SaraEye/SaraKIT-Schematic-and-BOM/SaraKit_MainBoard/support/RPI_CM4_Pinout.JPG

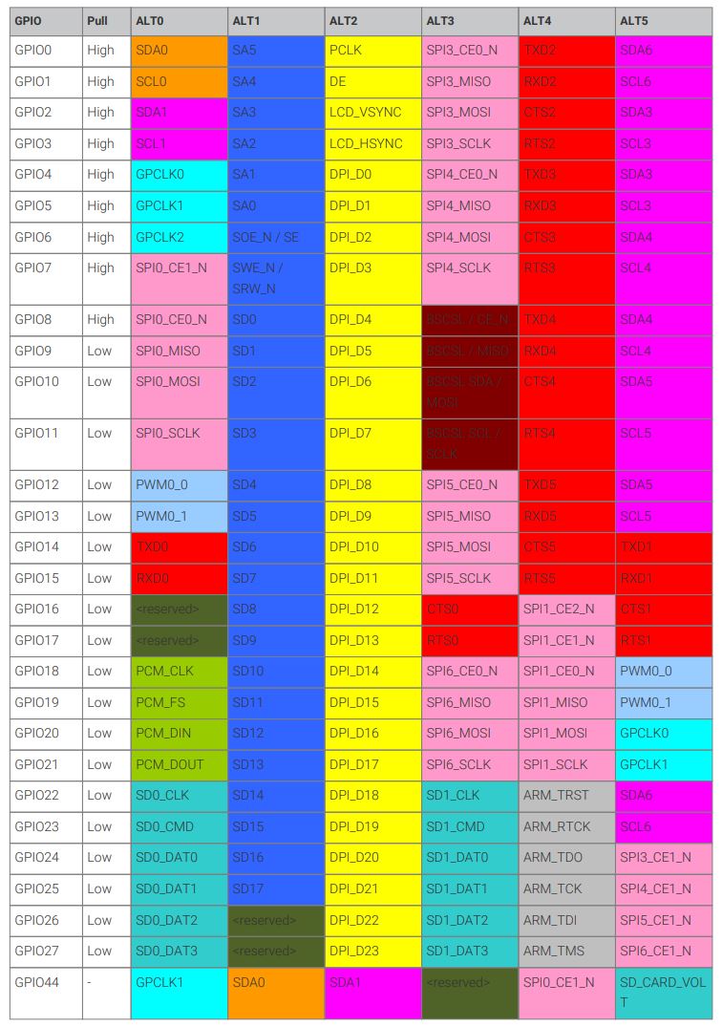
SaraKit_MainBoard/support/RPI_CM4_Pinout.JPG
