SaraEye/SaraKIT-Schematic-and-BOM/README.md

## SaraKIT Schematic and BOM

---

## SaraAI LLC

Website: [https://SaraAI.com](https://SaraAI.com)<br>
Project Page: [https://SaraKIT.SaraAI.com](https://SaraKIT.SaraAI.com)
