SaraEye/SaraKIT-Schematic-and-BOM/SaraKit_CameraHub_v11/out/[ASSEMBLY] SaraKit_CameraHub-v1.1 (2023-07-04)/BOM/[eBOM] SaraKit_CameraHub [Standard] [v1.1] (2023-07-04 18-40).xlsx

eBOM | SaraKit Camera Hub
Project: | SaraKit_CameraHub.PrjPcb |  |  |  |  |  |  | Quantity of devices: | 1
Variant: | Standard |  |  |  |  |  |  | Total price: | 0.00 USD
Version | v1.1 |  |  |  |  |  |  | One device price | 0.00 USD
Report Date: | 04.07.2023 | 18:40
Print Date: | 2023-07-04 | 18:41:01
Designator | Quantity | 02 MPN | 03 Manufacturer | 04 Main Group | 05 Sub Group | 06 Assembly | 16 Replacements | 19 Supplier | 21 Price 1 USD | 22 Price 10 USD | 23 Price 100 USD | 24 Price 1000 USD | Total Quantity of Elements | Total Price of Elements | Percent of device price
C1 | 1 | CL21A226MOQNNNE | Samsung | CAPACITOR | CERAMIC | SMT |  |  |  |  |  |  | 1 | 0.00 USD | #DIV/0!
C2, C3 | 2 | CL05A105KO5NNNC | Samsung | CAPACITOR | THICK FILM | SMT |  |  |  |  |  |  | 2 | 0.00 USD | #DIV/0!
J1 | 1 | 5046184012 | Molex | CONNECTOR | PCB | SMT |  |  |  |  |  |  | 1 | 0.00 USD | #DIV/0!
J2, J3 | 2 | 1-84952-5 | TE Connectivity | CONNECTOR | PCB | SMT |  |  |  |  |  |  | 2 | 0.00 USD | #DIV/0!
R1, R2, R3, R4 | 4 | RC0402JR-070RL | Yageo | RESISTOR | THICK FILM | SMT |  |  |  |  |  |  | 4 | 0.00 USD | #DIV/0!
R5, R6 | 2 | RC0402FR-0710KL | Yageo | RESISTOR | THICK FILM | SMT |  |  |  |  |  |  | 2 | 0.00 USD | #DIV/0!
U1 | 1 | LIS3DH | STMicroelectronics | IC | SENSOR | SMT |  |  |  |  |  |  | 1 | 0.00 USD | #DIV/0!
