SaraEye/SaraKIT-Schematic-and-BOM/SaraKit_FlexHubConnector/out/[ASSEMBLY] SaraKit_FlexHubConnector-v1.0 (2023-07-04)/BOM/[eBOM] SaraKit_FlexHubConnector [[No Variations]] [v1.0] (2023-07-04 18-42).xlsx

eBOM | SaraKit FlexHubConnector
Project: | SaraKit_FlexHubConnector.PrjPcb |  |  |  |  |  |  | Quantity of devices: | 1
Variant: | None |  |  |  |  |  |  | Total price: | 0.00 USD
Version | v1.0 |  |  |  |  |  |  | One device price | 0.00 USD
Report Date: | 04.07.2023 | 18:42
Print Date: | 2023-07-04 | 18:42:34
Designator | Quantity | 02 MPN | 03 Manufacturer | 04 Main Group | 05 Sub Group | 06 Assembly | #Column Name Error:' 16 Replacements | #Column Name Error:' 19 Supplier | #Column Name Error:' 21 Price 1 USD | #Column Name Error:' 22 Price 10 USD | #Column Name Error:' 23 Price 100 USD | #Column Name Error:' 24 Price 1000 USD | Total Quantity of Elements | Total Price of Elements | Percent of device price
J1, J2 | 2 | 5046224012 | Molex | CONNECTOR | PCB | SMT |  |  |  |  |  |  | 2 | 0.00 USD | #DIV/0!
 |  |  |  |  |  |  |  |  |  |  |  |  | 0 | 0.00 USD | #DIV/0!
 |  |  |  |  |  |  |  |  |  |  |  |  | 0 | 0.00 USD | #DIV/0!
