SaraEye/SaraKIT-Schematic-and-BOM/SaraKit_MainBoard/out/[ASSEMBLY] SaraKit_MainBoard-v1.1 (2023-07-04)/BOM/[eBOM] SaraKit_MainBoard [Standard] [v1.1] (2023-07-04 18-44).xlsx

eBOM | SaraKit Main Board
Project: | SaraKit_MainBoard.PrjPcb |  |  |  |  |  |  | Quantity of devices: | 1
Variant: | Standard |  |  |  |  |  |  | Total price: | 0.00 USD
Version | v1.1 |  |  |  |  |  |  | One device price | 0.00 USD
Report Date: | 04.07.2023 | 18:44
Print Date: | 2023-07-04 | 18:45:00
Designator | Quantity | 02 MPN | 03 Manufacturer | 04 Main Group | 05 Sub Group | 06 Assembly | 16 Replacements | 19 Supplier | 21 Price 1 USD | 22 Price 10 USD | 23 Price 100 USD | 24 Price 1000 USD | Total Quantity of Elements | Total Price of Elements | Percent of device price
ASM100 | 1 | CM4101008 | Raspberry Pi | IC | PROCESSOR | FAS |  |  |  |  |  |  | 1 | 0.00 USD | #DIV/0!
C100, C101, C106, C107, C216, C220, C221, C223, C225, C226, C228, C229, C230, C306, C308, C313, C315, C411, C412, C413, C422 | 21 | CL05A105KP5NNNC | Samsung | CAPACITOR | THICK FILM | SMT |  |  |  |  |  |  | 21 | 0.00 USD | #DIV/0!
C102, C103, C424, C509, C511, C512 | 6 | CL21A226MOQNNNE | Samsung | CAPACITOR | CERAMIC | SMT |  |  |  |  |  |  | 6 | 0.00 USD | #DIV/0!
C200, C203, C204, C205 | 4 | CL10A105KO8NNNC | Samsung | CAPACITOR | CERAMIC | SMT |  |  |  |  |  |  | 4 | 0.00 USD | #DIV/0!
C208, C209, C210, C211, C212, C213, C214, C215, C217, C218, C219, C222, C224, C400, C410, C423, C500 | 17 | CL05B104KO5NNNC | Samsung | CAPACITOR | CERAMIC | SMT |  |  |  |  |  |  | 17 | 0.00 USD | #DIV/0!
C300, C301, C401 | 3 | A768EB826M1ELAE036 | Kemet | CAPACITOR | POLYMER | SMT | 25SVPK82M |  |  |  |  |  | 3 | 0.00 USD | #DIV/0!
C302, C303, C304, C305, C307, C309 | 6 | CL21B105KBFNNNG | Samsung | CAPACITOR | CERAMIC | SMT |  |  |  |  |  |  | 6 | 0.00 USD | #DIV/0!
C310, C311, C316, C317 | 4 | CL10B474KA8NNNC | Samsung | CAPACITOR | CERAMIC | SMT |  |  |  |  |  |  | 4 | 0.00 USD | #DIV/0!
C312, C314, C318, C319 | 4 | CL10B102KB8NNNC | Samsung | CAPACITOR | CERAMIC | SMT |  |  |  |  |  |  | 4 | 0.00 USD | #DIV/0!
C320, C321 | 2 | CL05B103KB5NNN | Samsung | CAPACITOR | CERAMIC | SMT |  |  |  |  |  |  | 2 | 0.00 USD | #DIV/0!
C402, C403, C414, C415, C502, C503 | 6 | CL32B106KBJNNNE | Samsung | CAPACITOR | CERAMIC | SMT |  |  |  |  |  |  | 6 | 0.00 USD | #DIV/0!
C404, C416, C505 | 3 | CL10B104KB8NNNC | Samsung | CAPACITOR | CERAMIC | SMT |  |  |  |  |  |  | 3 | 0.00 USD | #DIV/0!
C405, C417 | 2 | CL10B103KB8NNNC | Samsung | CAPACITOR | CERAMIC | SMT |  |  |  |  |  |  | 2 | 0.00 USD | #DIV/0!
C406 | 1 | C0402C681J5GAC | Kemet | CAPACITOR | CERAMIC | SMT |  |  |  |  |  |  | 1 | 0.00 USD | #DIV/0!
C409, C421 | 2 | CL10B105KA8NNNC | Samsung | CAPACITOR | CERAMIC | SMT |  |  |  |  |  |  | 2 | 0.00 USD | #DIV/0!
C504 | 1 | CL10B332KB8NNNC | Samsung | CAPACITOR | CERAMIC | SMT |  |  |  |  |  |  | 1 | 0.00 USD | #DIV/0!
C506, C507 | 2 | ECASD40J476M025K00 | Murata | CAPACITOR | POLYMER | SMT |  |  |  |  |  |  | 2 | 0.00 USD | #DIV/0!
C513 | 1 | GRM1555C1H101JA01D | Murata | CAPACITOR | CERAMIC | SMT |  |  |  |  |  |  | 1 | 0.00 USD | #DIV/0!
C600, C601 | 2 | CL05A105KO5NNNC | Samsung | CAPACITOR | THICK FILM | SMT |  |  |  |  |  |  | 2 | 0.00 USD | #DIV/0!
D100 | 1 | TPD2E2U06DCKR | Texas Instruments | DIODE | TVS/ESD | SMT |  |  |  |  |  |  | 1 | 0.00 USD | #DIV/0!
D504, D505 | 2 | SK34A | Taiwan Semiconductor | DIODE | SCHOTTKY | SMT |  |  |  |  |  |  | 2 | 0.00 USD | #DIV/0!
J100, J101 | 2 | DF40HC(3.0)-100DS-0.4v | Hirose | CONNECTOR | PCB | SMT |  |  |  |  |  |  | 2 | 0.00 USD | #DIV/0!
J102 | 1 | 5046184012 | Molex | CONNECTOR | PCB | SMT |  |  |  |  |  |  | 1 | 0.00 USD | #DIV/0!
J103 | 1 | USB3140-30-0170-0-C | GCT | CONNECTOR | WIRE | SMD/THT |  |  |  |  |  |  | 1 | 0.00 USD | #DIV/0!
J104, J105 | 2 | 10129381-910001BLF | Amphenol | CONNECTOR | WIRE | THT |  |  |  |  |  |  | 2 | 0.00 USD | #DIV/0!
J300, J301 | 2 | 282834-2 | TE Connectivity | CONNECTOR | WIRE | THT |  |  |  |  |  |  | 2 | 0.00 USD | #DIV/0!
J400, J401 | 2 | 282834-3 | TE Connectivity | CONNECTOR | WIRE | THT |  |  |  |  |  |  | 2 | 0.00 USD | #DIV/0!
J402, J404 | 2 | 53047-0310 | Molex | CONNECTOR | WIRE | THT |  |  |  |  |  |  | 2 | 0.00 USD | #DIV/0!
J403 | 1 | G800W303018EU | Amphenol | CONNECTOR | WIRE | THT |  |  |  |  |  |  | 1 | 0.00 USD | #DIV/0!
J500 | 1 | PC-GK2.1 | NINIGI | CONNECTOR | WIRE | THT |  |  |  |  |  |  | 1 | 0.00 USD | #DIV/0!
L300, L301, L302, L303 | 4 | BLM21PG121SN1D | Murata | INDUCTOR | BEAD | SMT |  |  |  |  |  |  | 4 | 0.00 USD | #DIV/0!
L502 | 1 | SRR1050A-8R2Y | Bourns | INDUCTOR | WIREWOUND | SMT |  |  |  |  |  |  | 1 | 0.00 USD | #DIV/0!
L503 | 1 | SRN2510F-2R2M | Bourns | INDUCTOR | WIREWOUND | SMT |  |  |  |  |  |  | 1 | 0.00 USD | #DIV/0!
MIC200, MIC201, MIC202 | 3 | SPH0655LM4H-1 | Knowles | ACOUSTIC | MICROPHONE | SMT |  |  |  |  |  |  | 3 | 0.00 USD | #DIV/0!
Q100, Q300 | 2 | BC817-40W | Nexperia | TRANSISTOR | BIPOLAR | SMT |  |  |  |  |  |  | 2 | 0.00 USD | #DIV/0!
Q200 | 1 | IRLML2246TRPBF | International Rectifier | TRANSISTOR | MOSFET | SMT |  |  |  |  |  |  | 1 | 0.00 USD | #DIV/0!
R101, R102, R103, R104, R105, R106 | 6 | RC0603FR-074K7L | Yageo | RESISTOR | THICK FILM | SMT |  |  |  |  |  |  | 6 | 0.00 USD | #DIV/0!
R108, R200, R201, R203, R204, R207, R210, R212, R213, R501 | 10 | RC0603FR-0722RL | Yageo | RESISTOR | THICK FILM | SMT |  |  |  |  |  |  | 10 | 0.00 USD | #DIV/0!
R109, R202, R205, R206, R216, R218, R219, R220, R222, R300, R401, R405, R406, R410, R411, R412, R413, R505 | 18 | RC0402FR-0710KL | Yageo | RESISTOR | THICK FILM | SMT |  |  |  |  |  |  | 18 | 0.00 USD | #DIV/0!
R208, R301, R306, R307, R509 | 5 | RC0402FR-07100KL | Yageo | RESISTOR | THICK FILM | SMT |  |  |  |  |  |  | 5 | 0.00 USD | #DIV/0!
R211, R402 | 2 | 0402WGJ0101TCE | Royal Ohm | RESISTOR | THICK FILM | SMT |  |  |  |  |  |  | 2 | 0.00 USD | #DIV/0!
R221 | 1 | RC0402FR-07470RL | Yageo | RESISTOR | THICK FILM | SMT |  |  |  |  |  |  | 1 | 0.00 USD | #DIV/0!
R303 | 1 | RC0603FR-0710RL | Yageo | RESISTOR | THICK FILM | SMT |  |  |  |  |  |  | 1 | 0.00 USD | #DIV/0!
R308, R309, R310, R311 | 4 | RC0402FR-07220RL | Yageo | RESISTOR | THICK FILM | SMT |  |  |  |  |  |  | 4 | 0.00 USD | #DIV/0!
R400 | 1 | ERJ-8CWFR039V | Panasonic | RESISTOR | THICK FILM | SMT |  |  |  |  |  |  | 1 | 0.00 USD | #DIV/0!
R500 | 1 | RC0402FR-0743KL | Yageo | RESISTOR | THICK FILM | SMT |  |  |  |  |  |  | 1 | 0.00 USD | #DIV/0!
R502 | 1 | RC0402FR-078K2L | Yageo | RESISTOR | THICK FILM | SMT |  |  |  |  |  |  | 1 | 0.00 USD | #DIV/0!
R504 | 1 | RC0402FR-0715KL | Yageo | RESISTOR | THICK FILM | SMT |  |  |  |  |  |  | 1 | 0.00 USD | #DIV/0!
R507 | 1 | RC0603FR-07453KL | Yageo | RESISTOR | THICK FILM | SMT |  |  |  |  |  |  | 1 | 0.00 USD | #DIV/0!
R508 | 1 | RC0402FR-07200KL | Yageo | RESISTOR | THICK FILM | SMT |  |  |  |  |  |  | 1 | 0.00 USD | #DIV/0!
U200 | 1 | TLV70233DBV | Texas Instruments | IC | VOLTAGE REGULATOR | SMT |  |  |  |  |  |  | 1 | 0.00 USD | #DIV/0!
U201 | 1 | TLV70212DBV | Texas Instruments | IC | VOLTAGE REGULATOR | SMT |  |  |  |  |  |  | 1 | 0.00 USD | #DIV/0!
U204 | 1 | ZL38063LDG1 | Microchip | IC | PROCESSOR | SMT |  |  |  |  |  |  | 1 | 0.00 USD | #DIV/0!
U205 | 1 | AT25FF041A-SSHN-T | Adesto | IC | MEMORY | SMT |  |  |  |  |  |  | 1 | 0.00 USD | #DIV/0!
U300 | 1 | TPA3113D2PWPR | Texas Instruments | IC | DRIVER | SMT |  |  |  |  |  |  | 1 | 0.00 USD | #DIV/0!
U400, U403 | 2 | DRV8313PWP | Texas Instruments | IC | DRIVER | SMT |  |  |  |  |  |  | 2 | 0.00 USD | #DIV/0!
U401 | 1 | INA185A1IDR | Texas Instruments | IC | AMPLIFIER | SMT |  |  |  |  |  |  | 1 | 0.00 USD | #DIV/0!
U402 | 1 | dsPIC33CK32MP503 | Microchip | IC | MICROCONTROLLER | SMT |  |  |  |  |  |  | 1 | 0.00 USD | #DIV/0!
U500 | 1 | AP64350 | Diodes | IC | DCDC CONVERTER | SMT | AP64500SP-13 |  |  |  |  |  | 1 | 0.00 USD | #DIV/0!
U501 | 1 | TLV62569PDDC | Texas Instruments | IC | DCDC CONVERTER | SMT |  |  |  |  |  |  | 1 | 0.00 USD | #DIV/0!
U600 | 1 | LIS3DH | STMicroelectronics | IC | SENSOR | SMT |  |  |  |  |  |  | 1 | 0.00 USD | #DIV/0!
Y200 | 1 | MCSJK-3N-12.00-3.3-50-C | Multicomp | OSCILLATOR | XO | SMT |  |  |  |  |  |  | 1 | 0.00 USD | #DIV/0!
