SaraEye/SaraKIT-Schematic-and-BOM/SaraKit_CameraHub_v11/out/[3DMODEL] SaraKit_CameraHub-v1.1 (2023-07-04)/[STEP] SaraKit_CameraHub [Standard] [v1.1] (2023-07-04 18-41).step

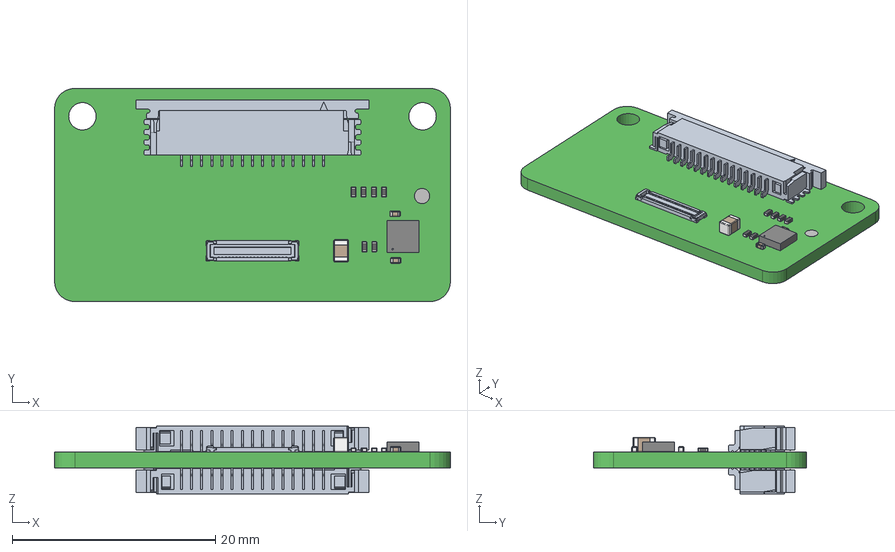
[picture p2: CAD file, 2023-07-19]
SaraKit_CameraHub_v11/out/[3DMODEL] SaraKit_CameraHub-v1.1 (2023-07-04)/[STEP] SaraKit_CameraHub [Standard] [v1.1] (2023-07-04 18-41).step
39.0 x 21.0 x 6.68 mm
c-1-84952-5-a-3d x 2
RESC1005X40L x 6
LGA-16_3x3x1mm_STM
CAPC1005X55N x 2
CAPC2013X145N
