SaraEye/SaraKIT-Schematic-and-BOM/(list of files, cad)

Other CAD files:
SaraKit_CameraHub_v11/out/[3DMODEL] SaraKit_CameraHub-v1.1 (2023-07-04)/[PARASOLID] SaraKit_CameraHub [Standard] [v1.1] (2023-07-04 18-41).x_t
SaraKit_FlexHubConnector/out/[3DMODEL] SaraKit_FlexHubConnector-v1.0 (2023-07-04)/[PARASOLID] SaraKit_FlexHubConnector [[No Variations]] [v1.0] (2023-07-04 18-42).x_t
SaraKit_MainBoard/out/[3DMODEL] SaraKit_MainBoard-v1.1 (2023-07-04)/[PARASOLID] SaraKit_MainBoard [Standard] [v1.1] (2023-07-04 18-45).x_t
