SaraEye/SaraKIT-Schematic-and-BOM/SaraKit_CameraHub_v11/out/[FABRICATION] SaraKit_CameraHub-v1.1 (2023-07-04)/[STACK] SaraKit_CameraHub [Standard] [v1.1] (2023-07-04 18-40).xls

Board Stack Report
Stack Up |  | Layer Stack
Layer | Board Layer Stack | Name | Material | Thickness | Constant
1 |  | Top Paste
2 |  | Top Overlay
3 |  | Top Solder | Solder Resist | 0,010mm | 3,5
4 |  | Top Copper | Copper | 0,036mm
5 |  | Dielectric 1 | FR-4 | 0,122mm | 4,2
6 |  | 2 | Copper | 0,035mm
7 |  | Dielectric 2 | FR-4 | 1,150mm | 4,2
8 |  | 3 | Copper | 0,035mm
9 |  | Dielectric 3 | FR-4 | 0,122mm | 4,2
10 |  | Bottom Copper | Copper | 0,036mm
11 |  | Bottom Solder | Solder Resist | 0,010mm | 3,5
12 |  | Bottom Overlay
13 |  | Bottom Paste
 | Height : 1,555mm
