SaraEye/SaraKIT-Schematic-and-BOM/SaraKit_FlexHubConnector/out/[FABRICATION] SaraKit_FlexHubConnector-v1.0 (2023-07-04)/[STACK] SaraKit_FlexHubConnector [[No Variations]] [v1.0] (2023-07-04 18-42).xls

Board Stack Report
Stack Up |  |  |  | Layer Stack
Layer | Stiffener BOTTOM | Flex | Stiffener TOP | Name | Material | Thickness | Constant
1 |  |  |  | Top Paste
2 |  |  |  | Stiffener TOP | FR4 | 1,000mm | 4,3
3 |  |  |  | Top Overlay
4 |  |  |  | Top Solder | Solder Resist | 0,050mm | 3,5
5 |  |  |  | Top Layer | Copper | 0,018mm
6 |  |  |  | Adhesive 1 |  | 0,020mm | 3,4
7 |  |  |  | PI | Polyamid | 0,025mm | 3,4
8 |  |  |  | Adhesive 2 |  | 0,020mm | 3,4
9 |  |  |  | Bottom Layer | Copper | 0,018mm
10 |  |  |  | Bottom Solder | Solder Resist | 0,050mm | 3,5
11 |  |  |  | Bottom Overlay
12 |  |  |  | Stiffener BOTTOM | FR4 | 1,000mm | 4,3
13 |  |  |  | Bottom Paste
 | Height : 1,201mm | Height : 0,201mm | Height : 1,201mm
