SaraEye/SaraKIT-Schematic-and-BOM/SaraKit_MainBoard/out/[FABRICATION] SaraKit_MainBoard-v1.1 (2023-07-04)/[STACK] SaraKit_MainBoard [Standard] [v1.1] (2023-07-04 18-45).xls

Board Stack Report
Stack Up |  | Layer Stack
Layer | Board Layer Stack | Name | Material | Thickness | Constant
1 |  | Top Paste
2 |  | Top Overlay
3 |  | Top Solder | Solder Resist | 0,010mm | 3,5
4 |  | L1 | Copper | 0,035mm
5 |  | Dielectric 2 | FR4 | 0,122mm | 4,2
6 |  | L2 | Copper | 0,035mm
7 |  | Dielectric 1 | FR-4 | 1,150mm | 4,2
8 |  | L3 | Copper | 0,035mm
9 |  | Dielectric 5 | FR4 | 0,122mm | 4,2
10 |  | L4 | Copper | 0,035mm
11 |  | Bottom Solder | Solder Resist | 0,010mm | 3,5
12 |  | Bottom Overlay
13 |  | Bottom Paste
 | Height : 1,554mm
