SaraEye/SaraKIT-Schematic-and-BOM/SaraKit_MainBoard/out/[SCH] SaraKit_MainBoard [Standard] [v1.1] (2023-07-04 18-44).PDF

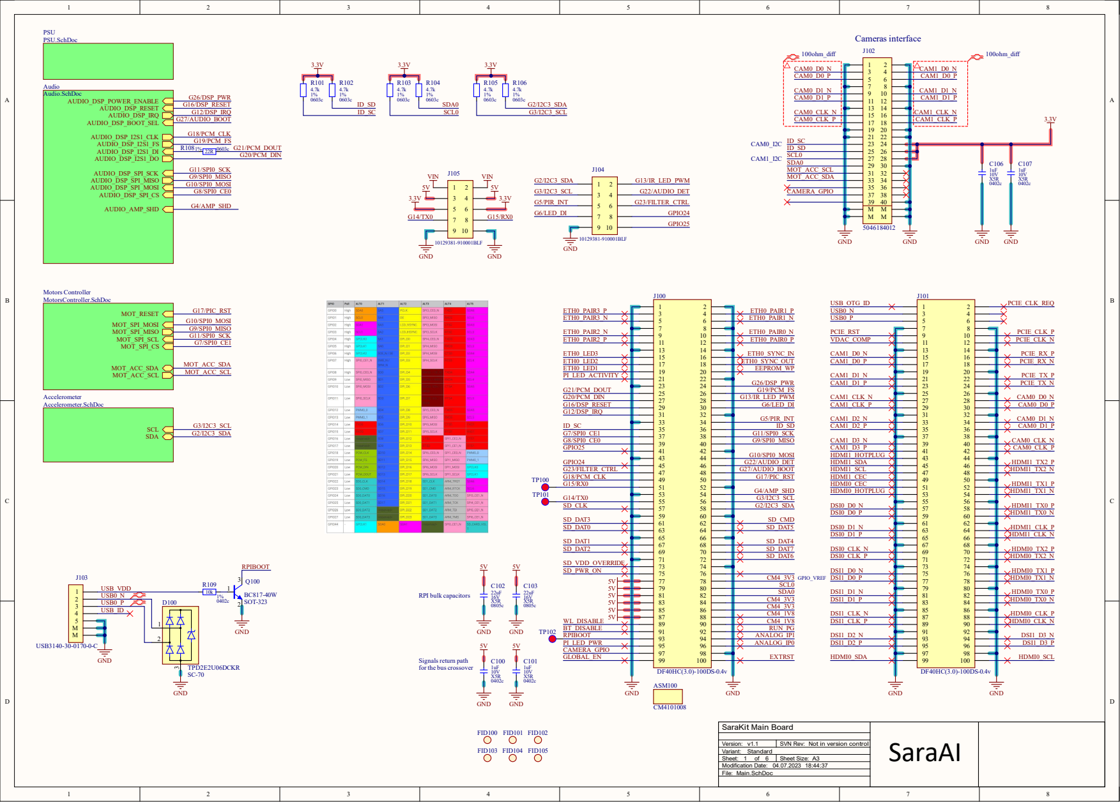
[picture p3: page 1]

USB0_P
USB_ID

Signals return path
for the bus crossover

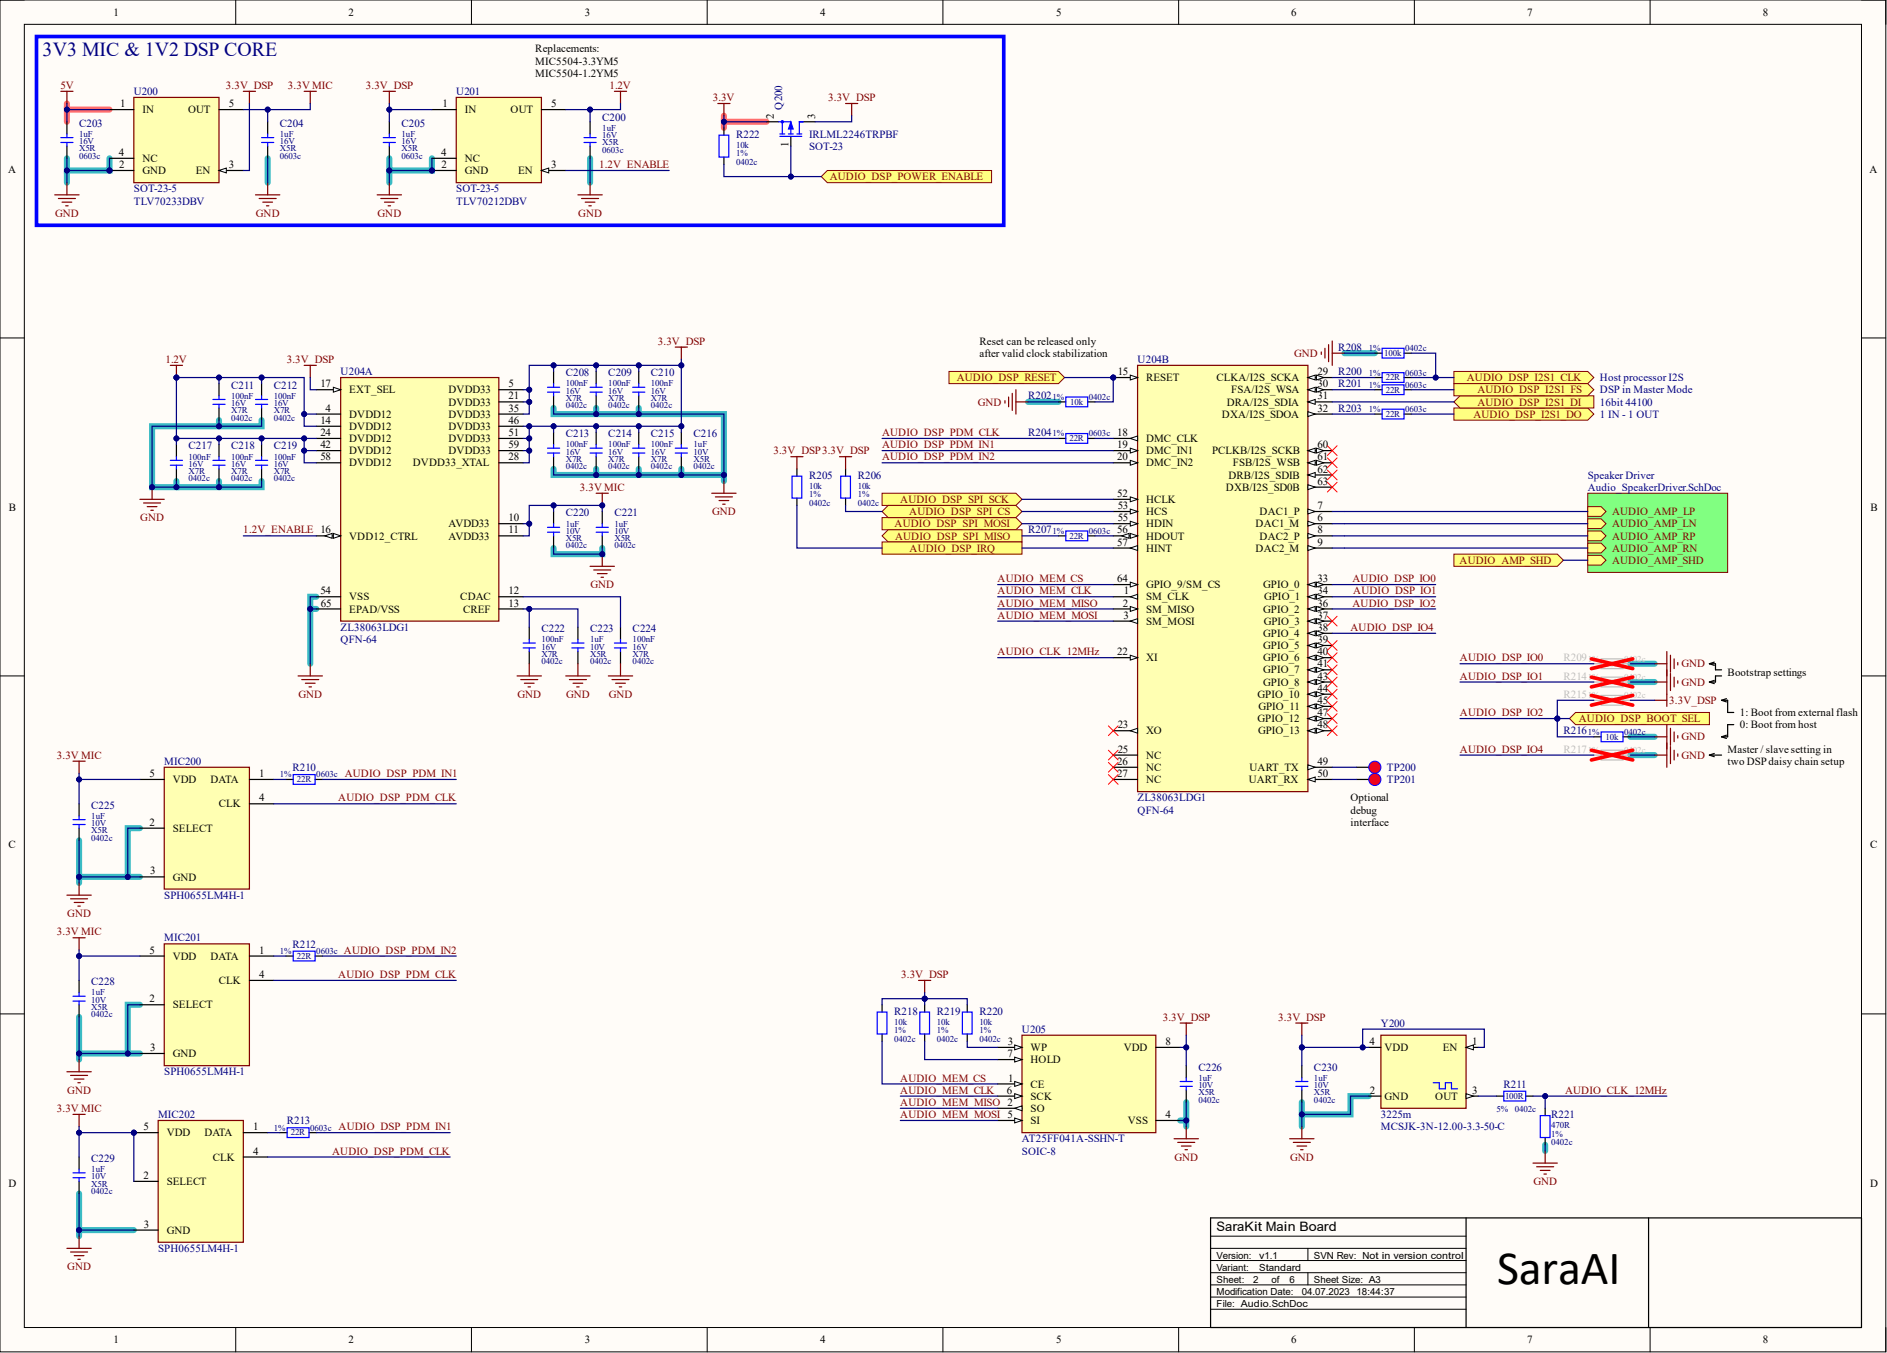
[picture p4: page 2]

Reset can be released only
after valid clock stabilization

1: Boot from external flash

two DSP daisy chain setup

SELECT 2

10V | GND 2

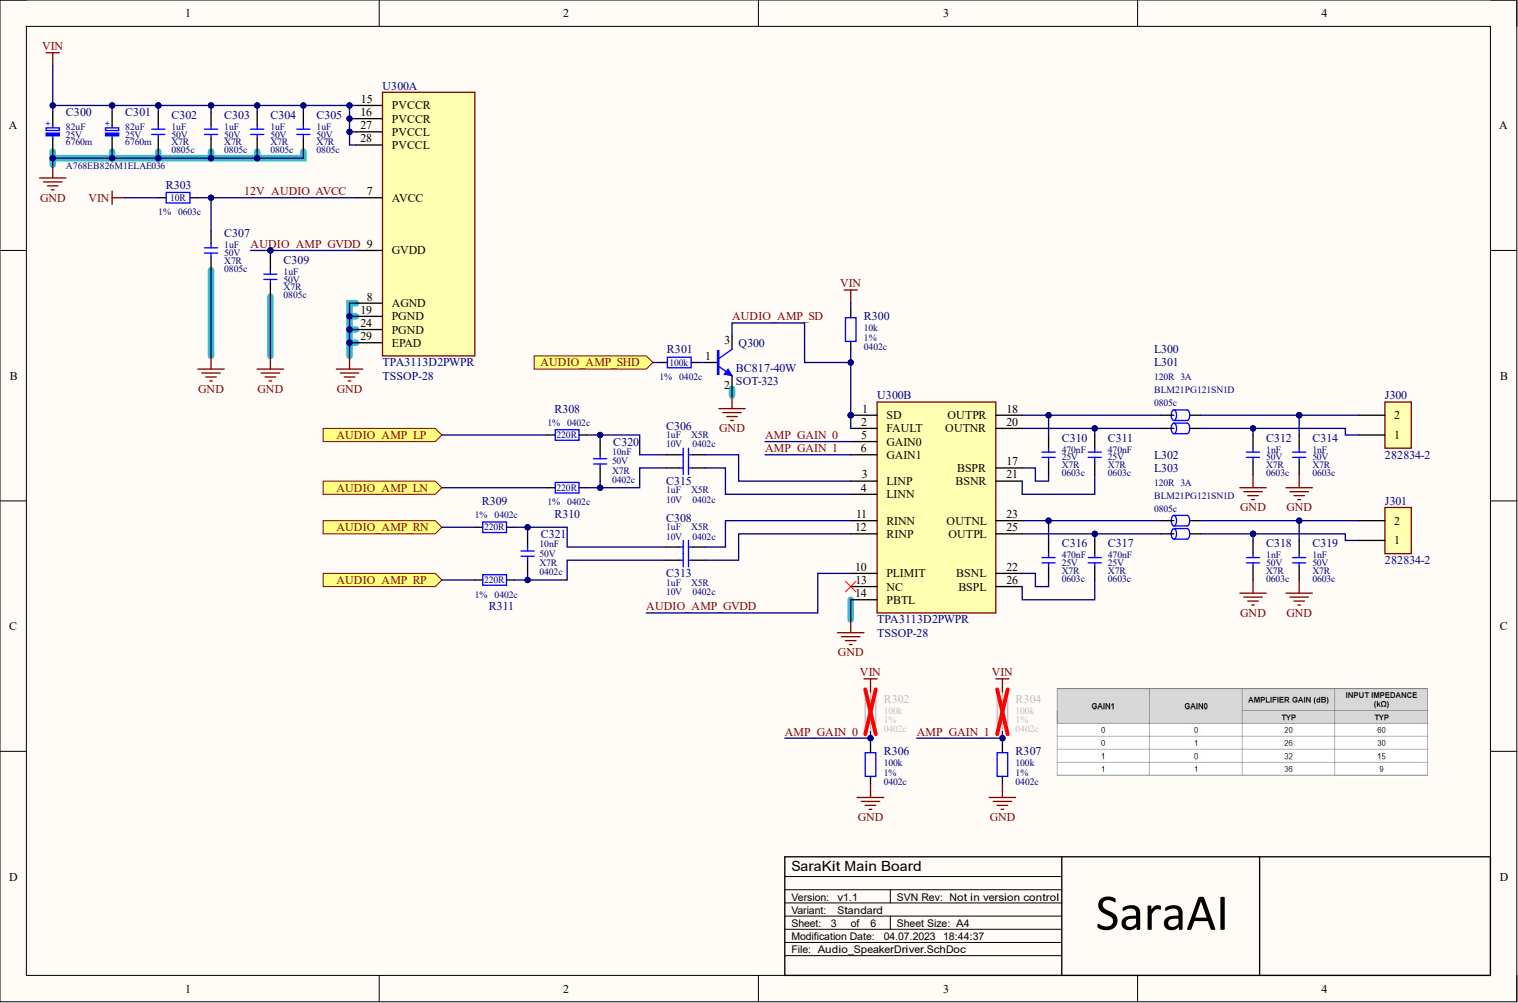
[picture p5: page 3]

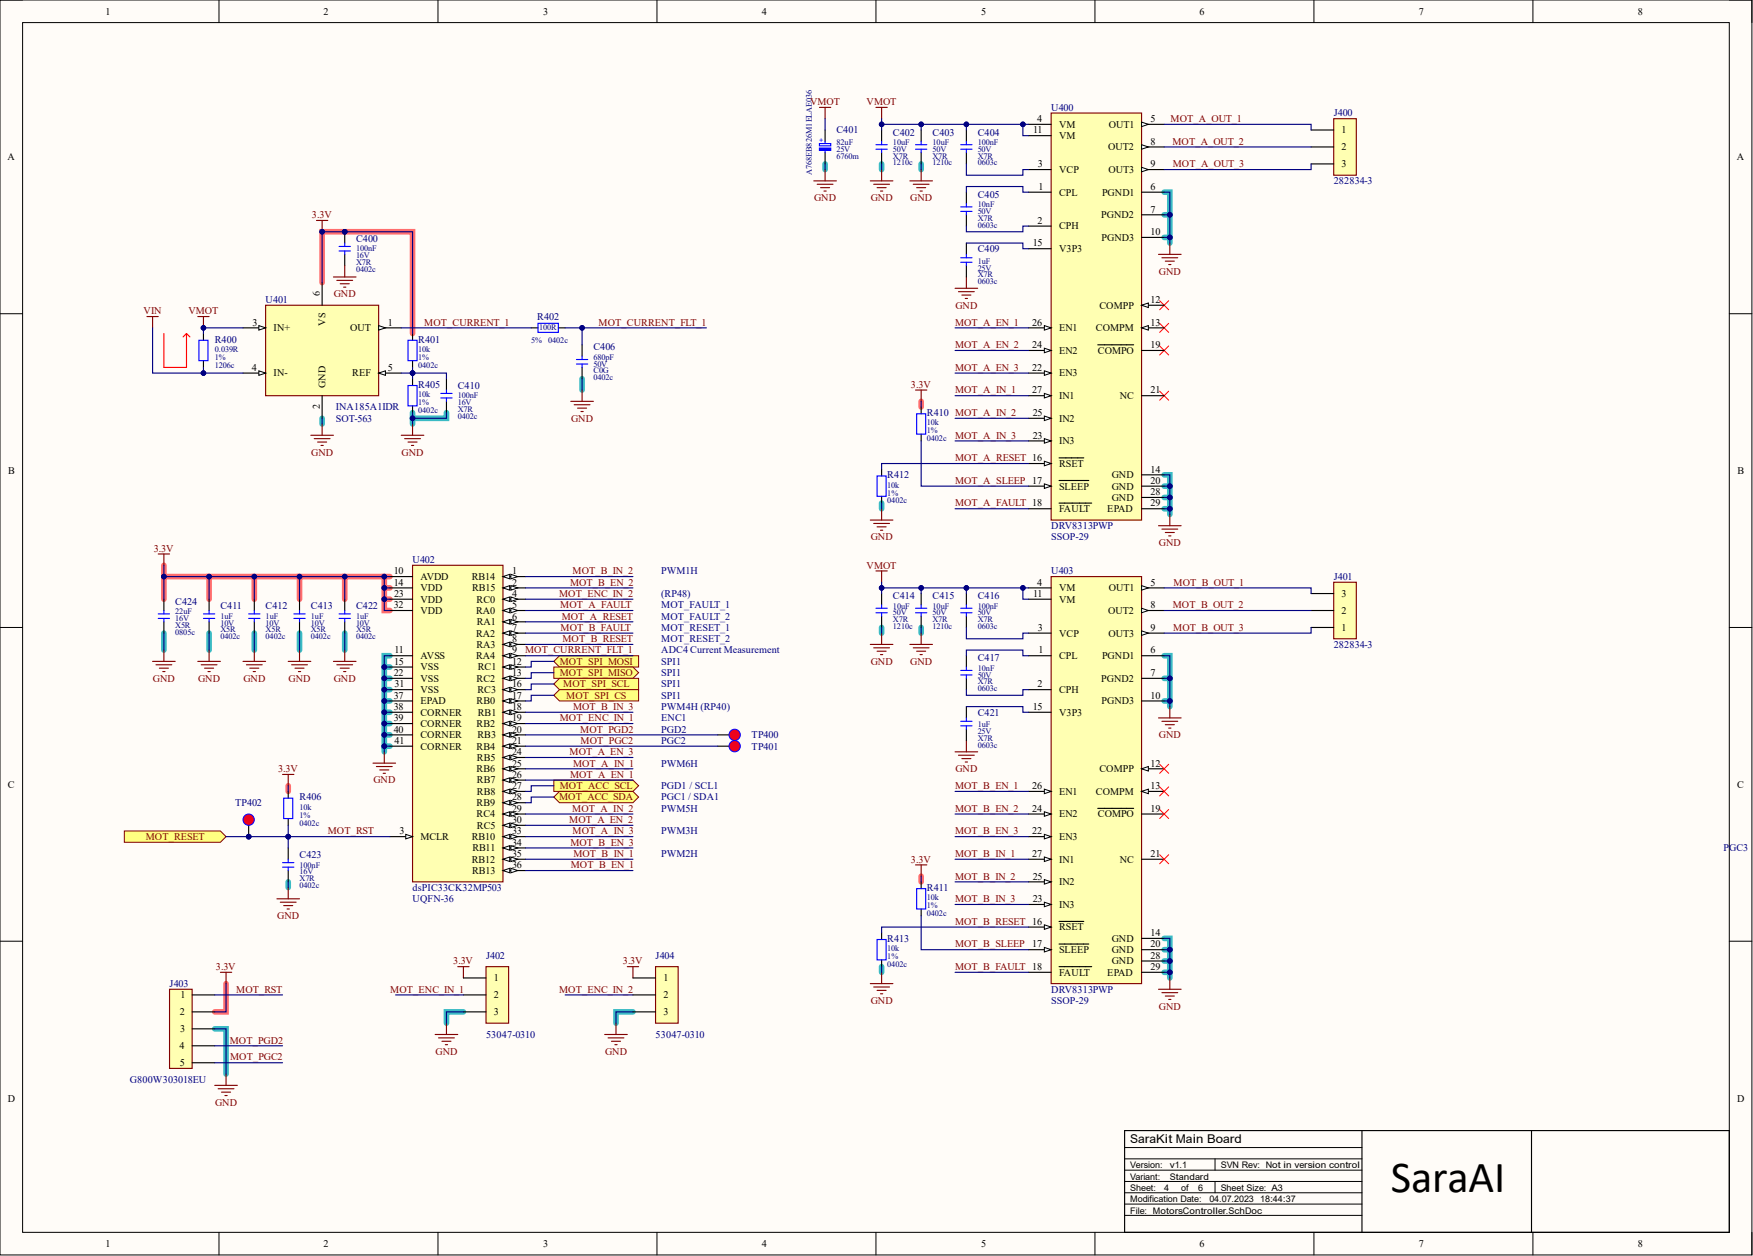
[picture p6: page 4]

GND | 100nF 16V

MOT_A_RESET | RSET 16

MOT_A_SLEEP

SLEEP 17

MOT_B_SLEEP

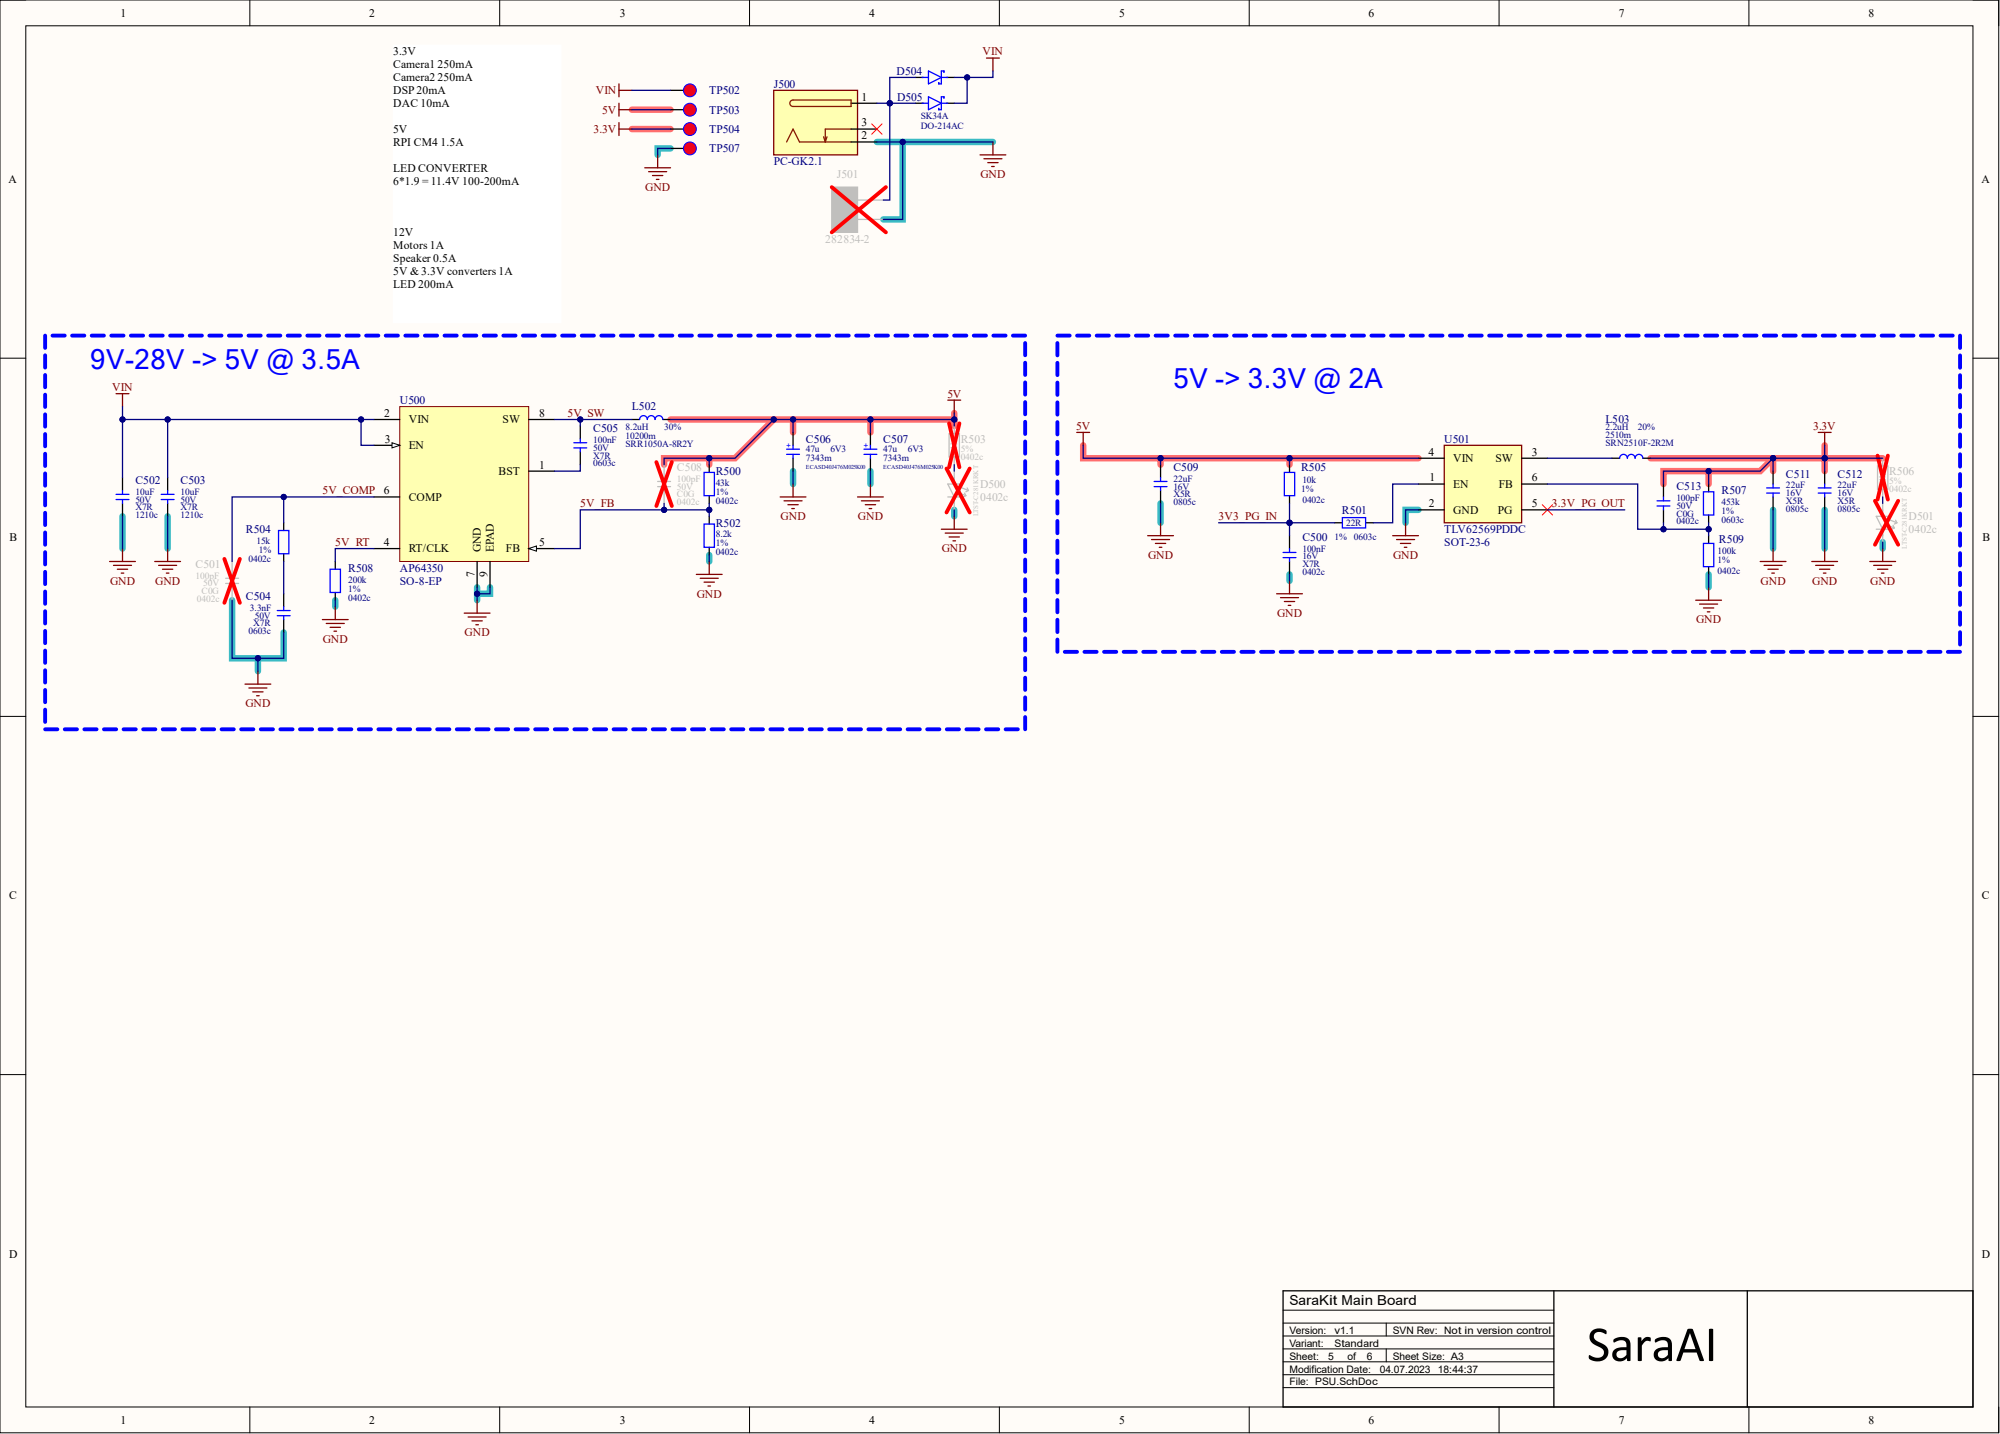
[picture p7: page 5]

GND 2

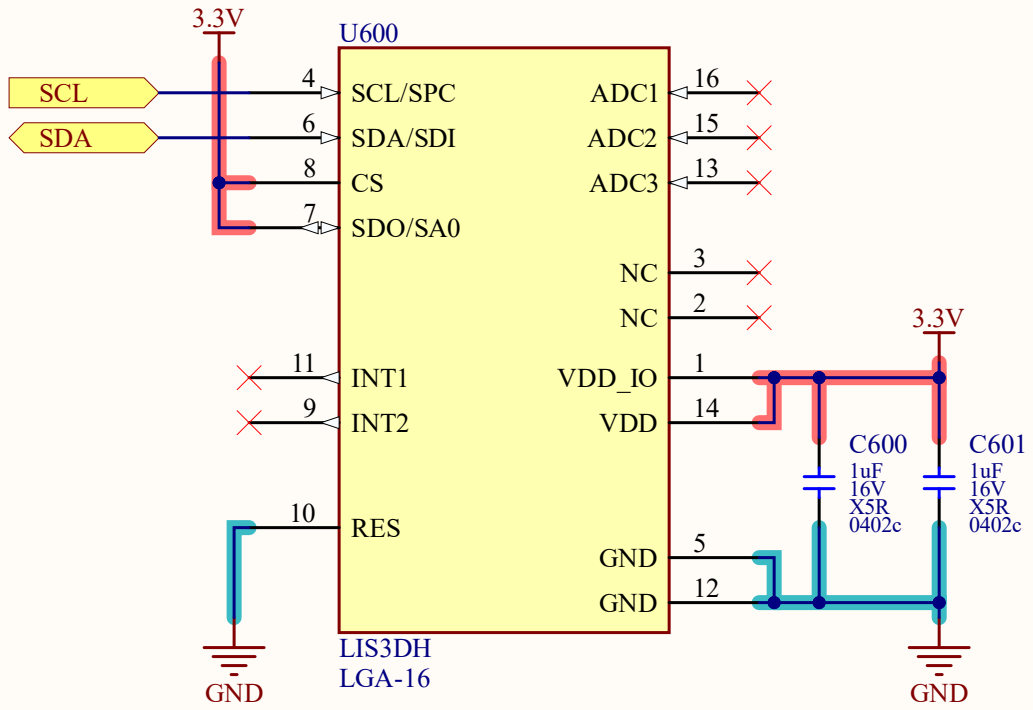
[picture p8: page 6]
