SaraEye/SaraKIT-Schematic-and-BOM/SaraKit_MainBoard/out/[ASSEMBLY] SaraKit_MainBoard-v1.1 (2023-07-04)/AssemblyPrint/[AssemblyPrint] SaraKit_MainBoard [Standard] [v1.1] (2023-07-04 18-44).PDF

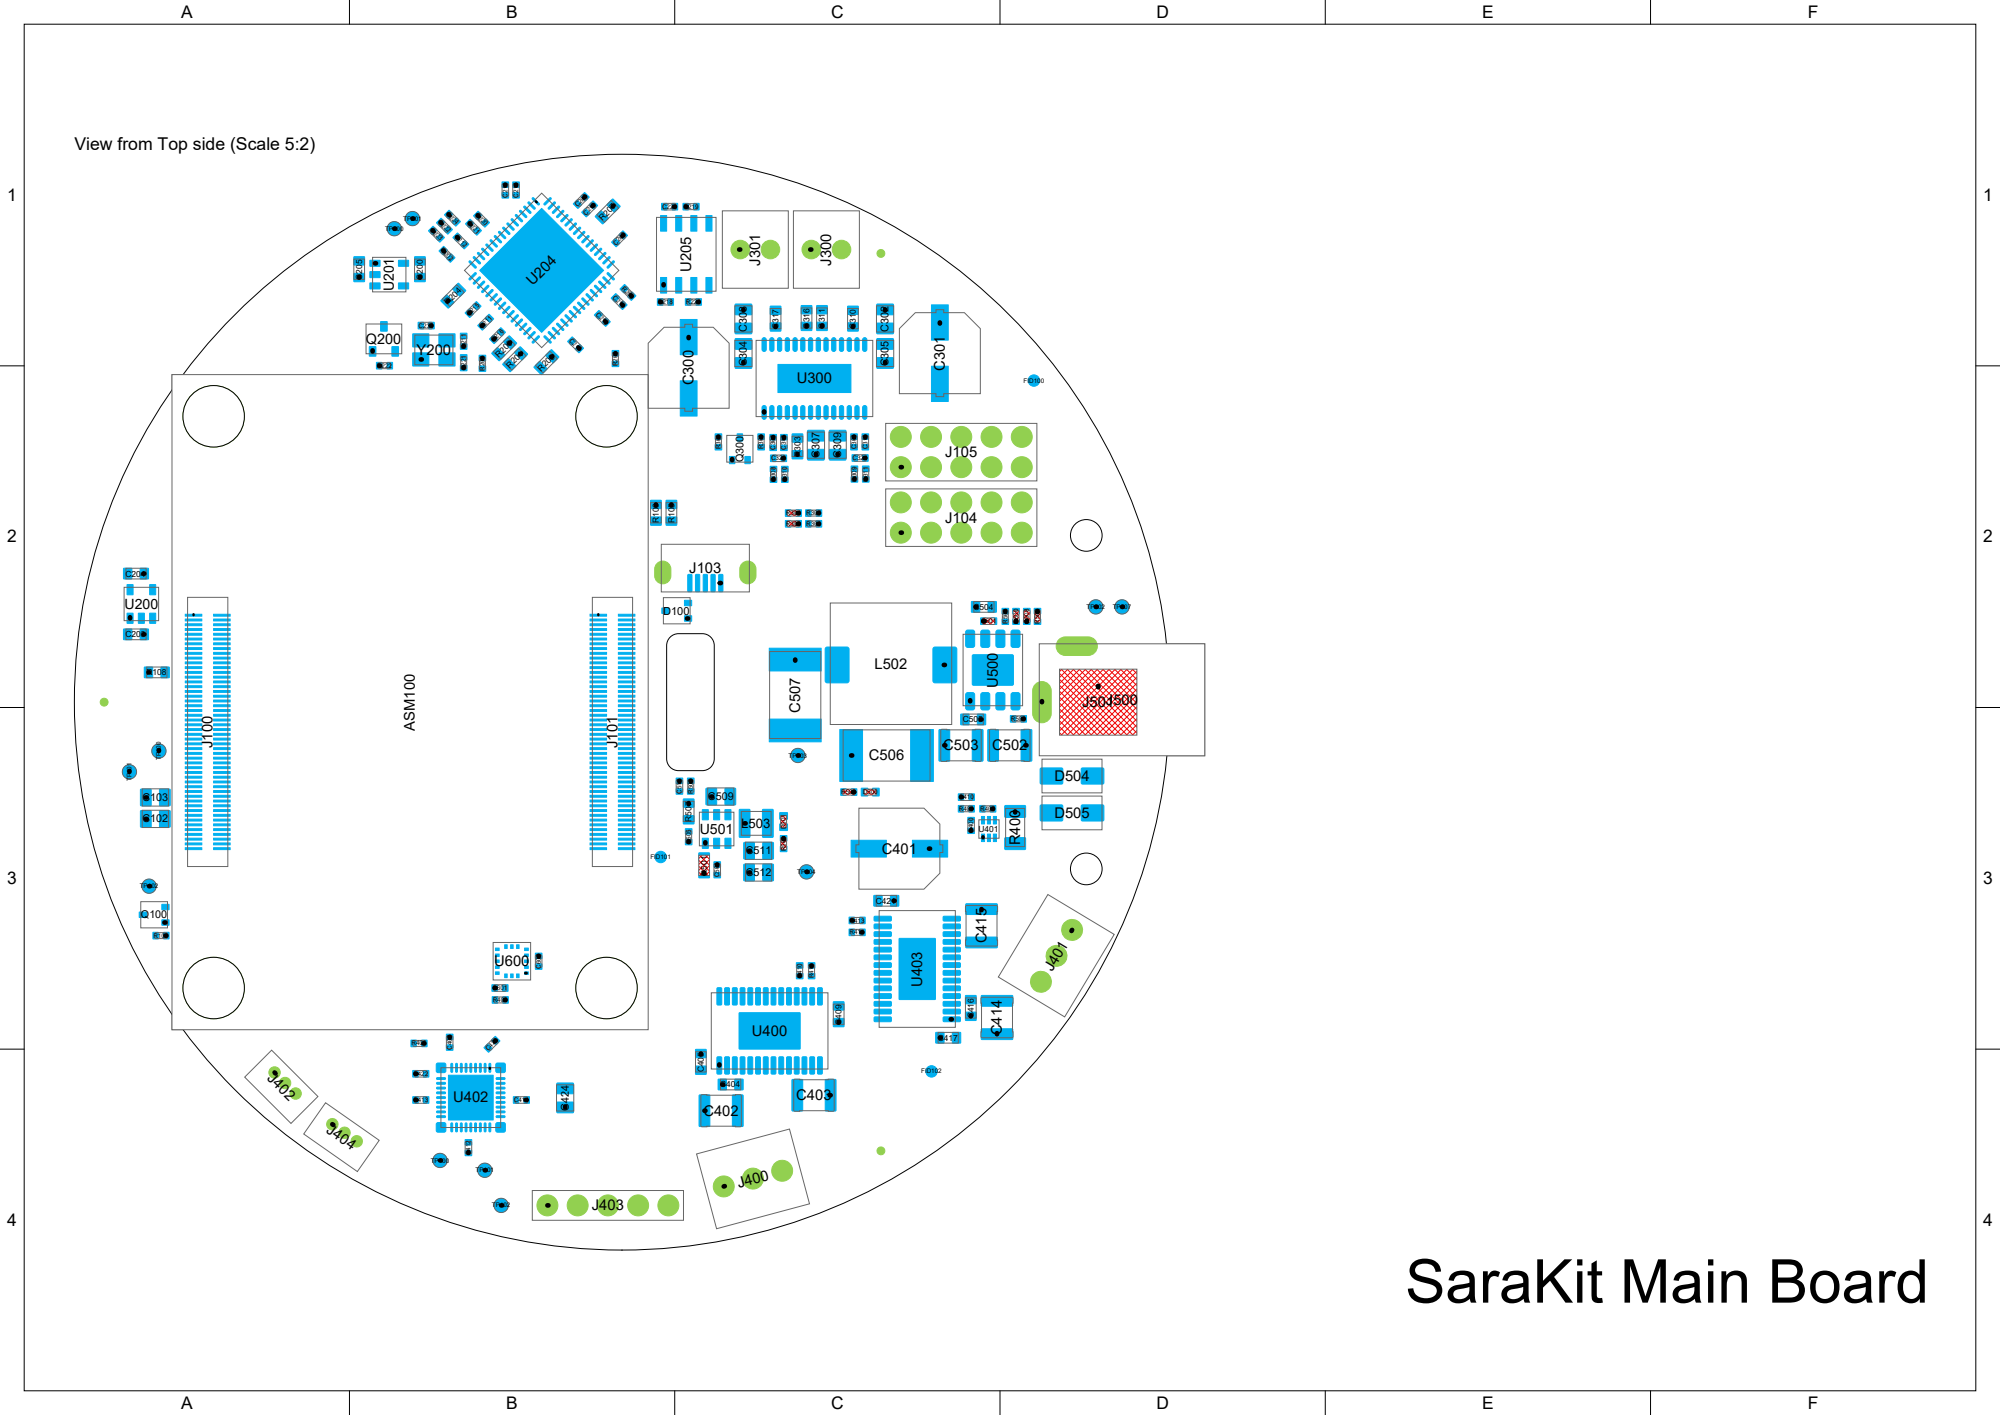
[picture p9: page 1]

View from Top side (Scale 5:2)

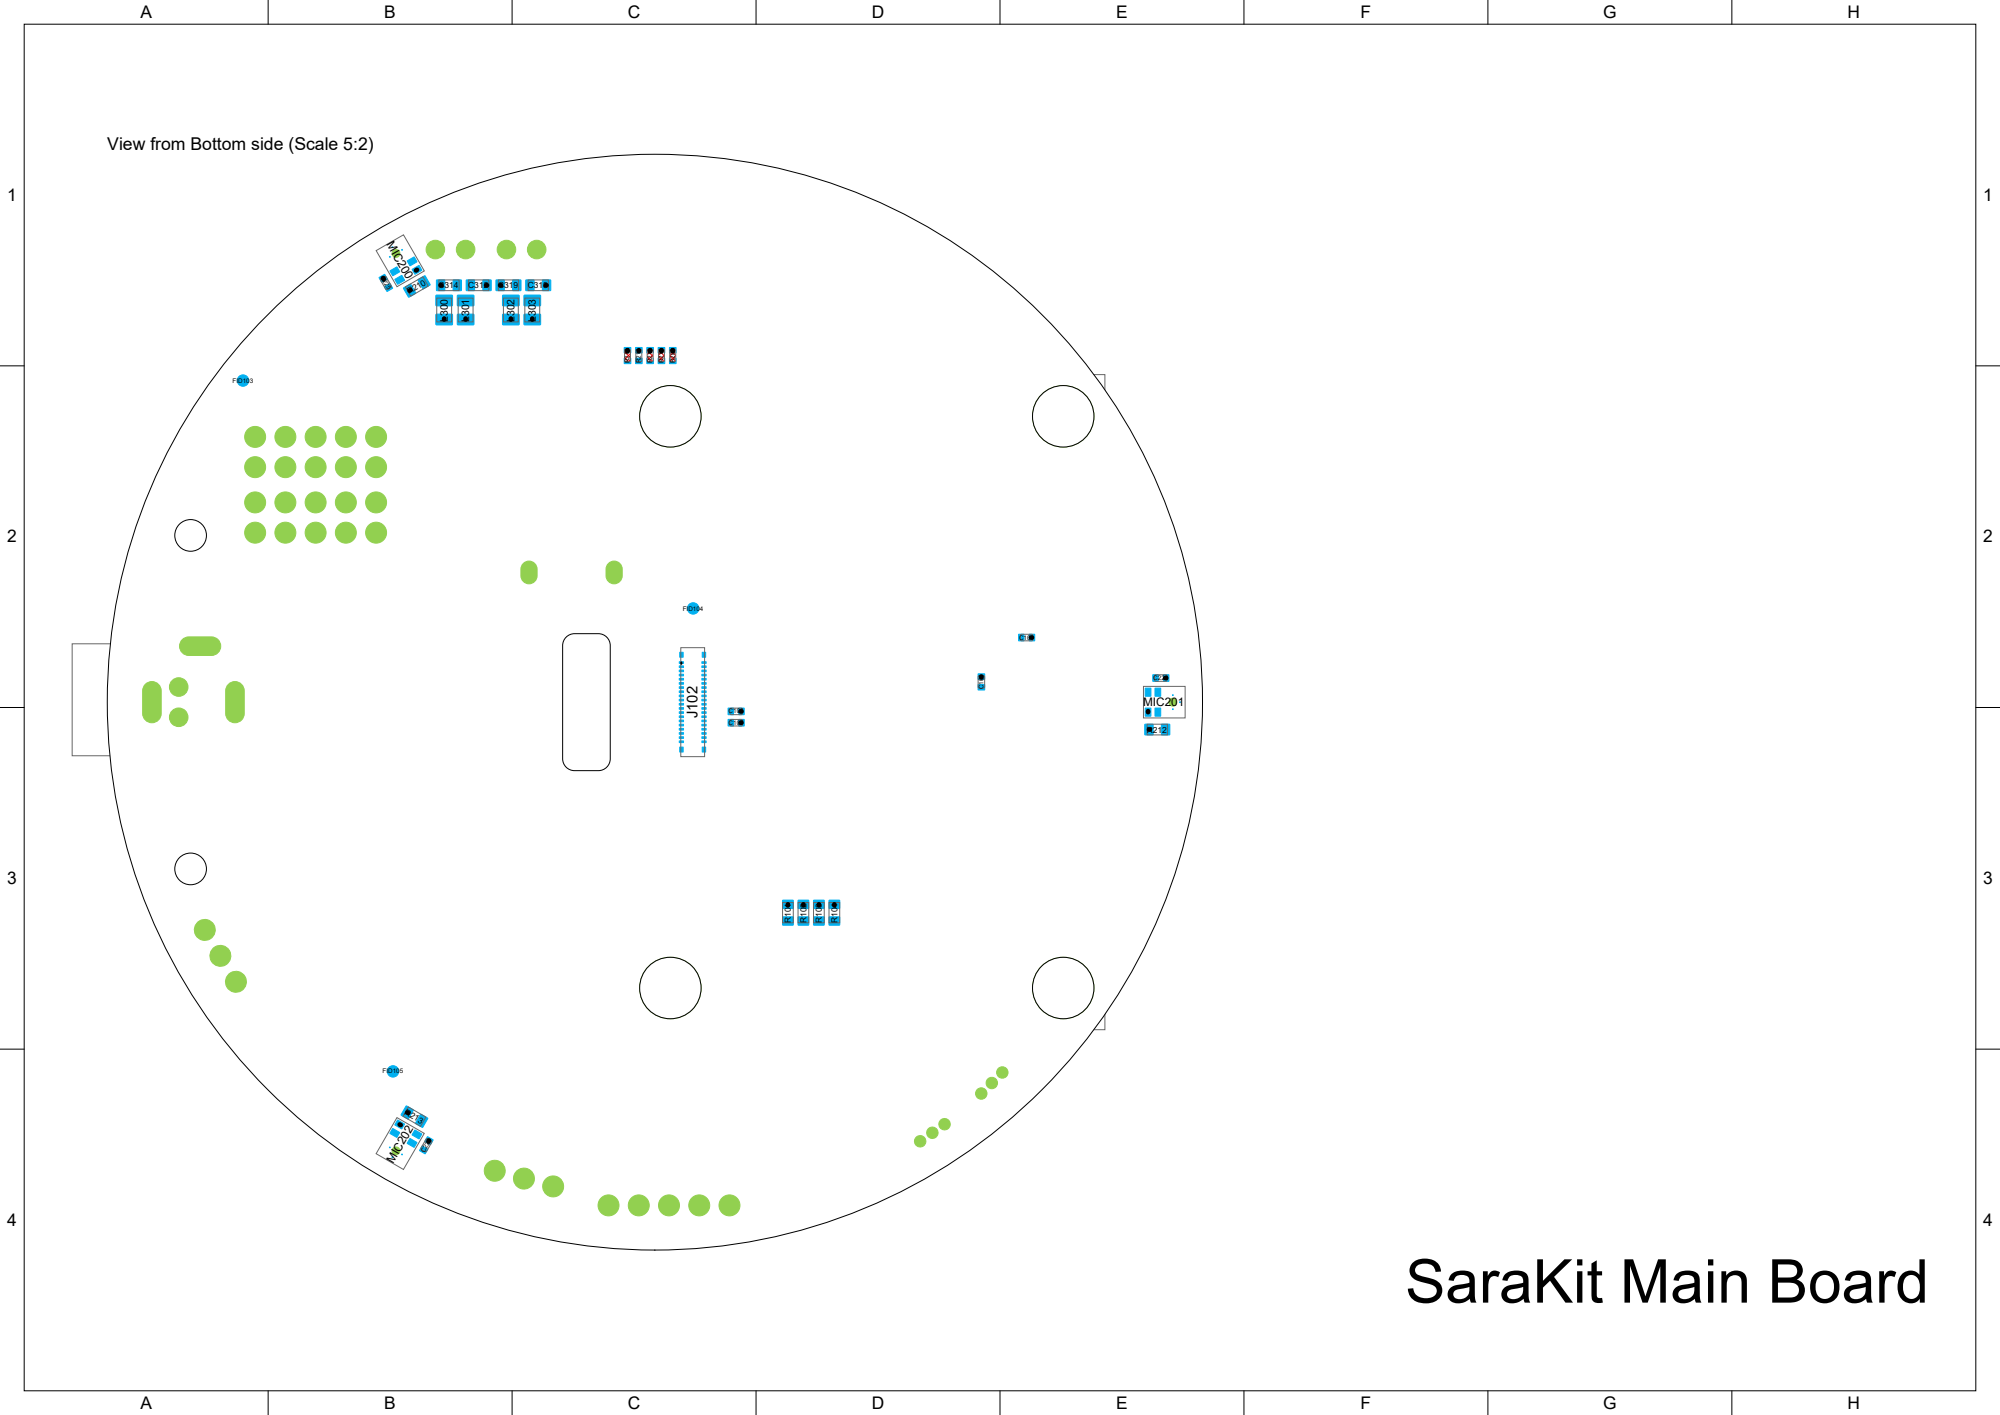
[picture p10: page 2]

View from Bottom side (Scale 5:2)
