SaraEye/SaraKIT-Schematic-and-BOM/SaraKit_CameraHub_v11/out/[PCB-4L-Review] SaraKit_CameraHub [Standard] [v1.1] (2023-07-04 18-40).PDF

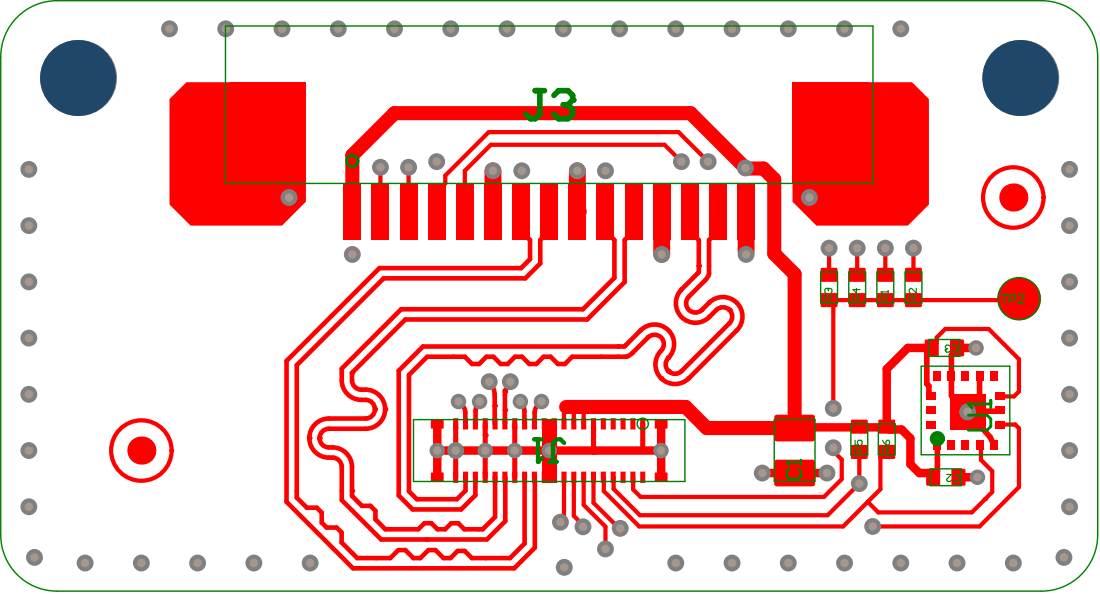
[picture p11: page 1]

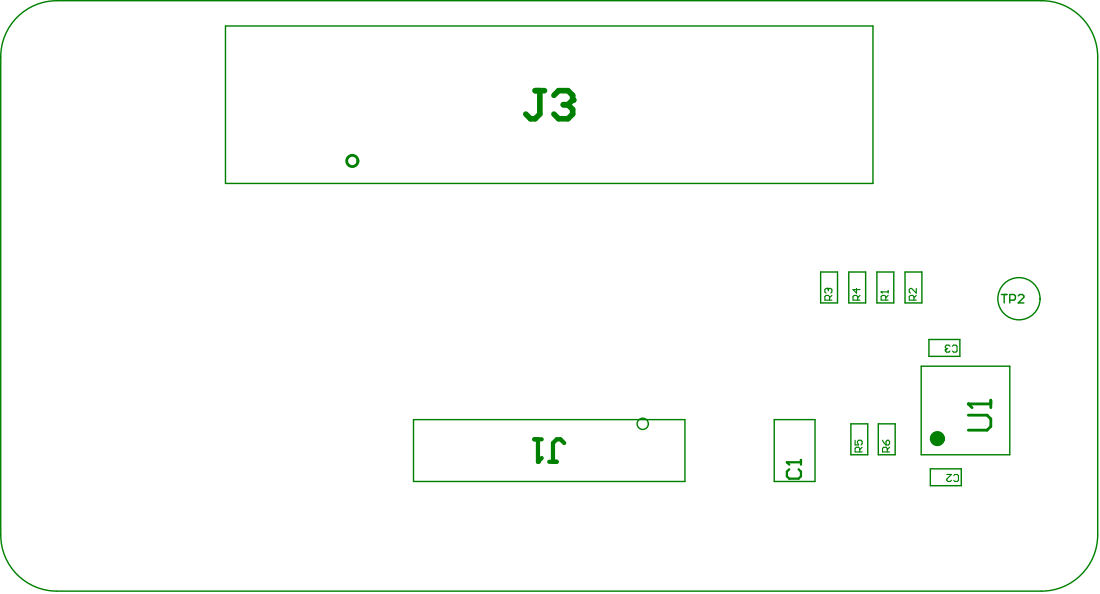
[picture p12: page 2]

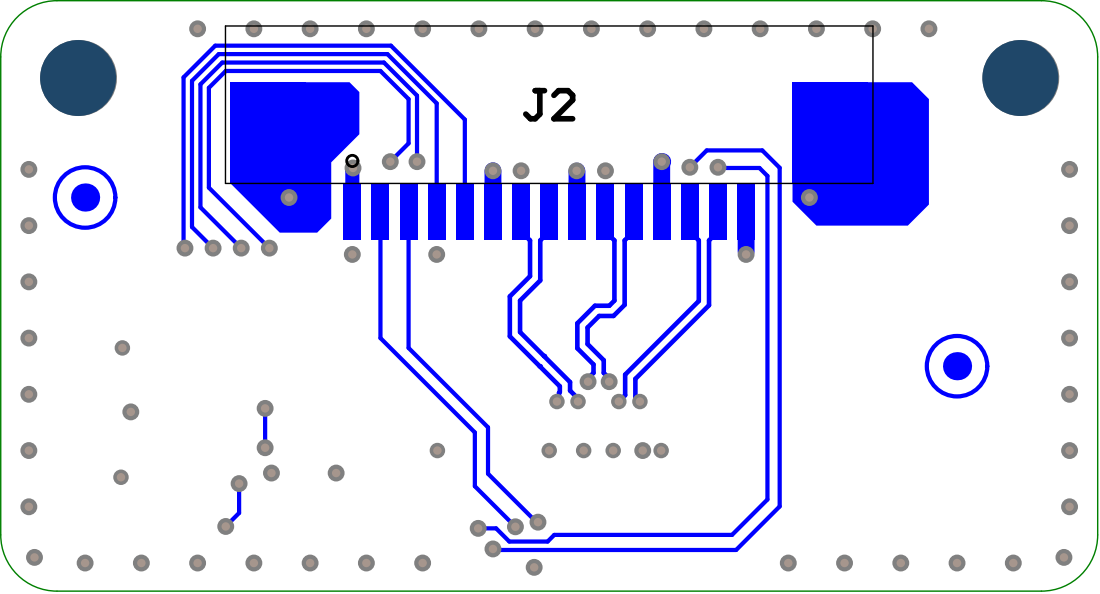
[picture p13: page 3]

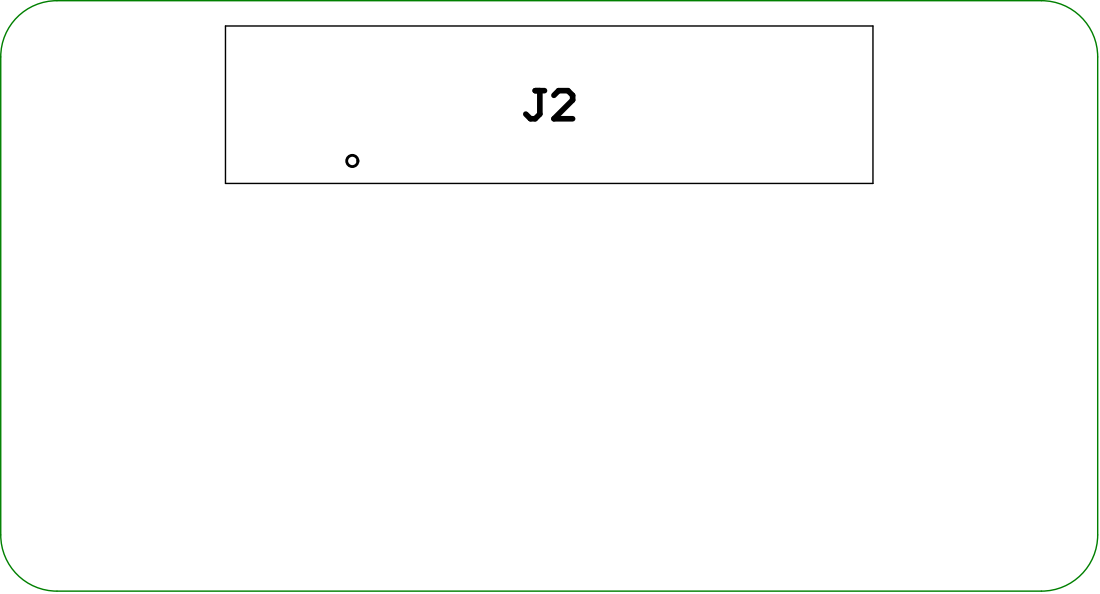
[picture p14: page 4]

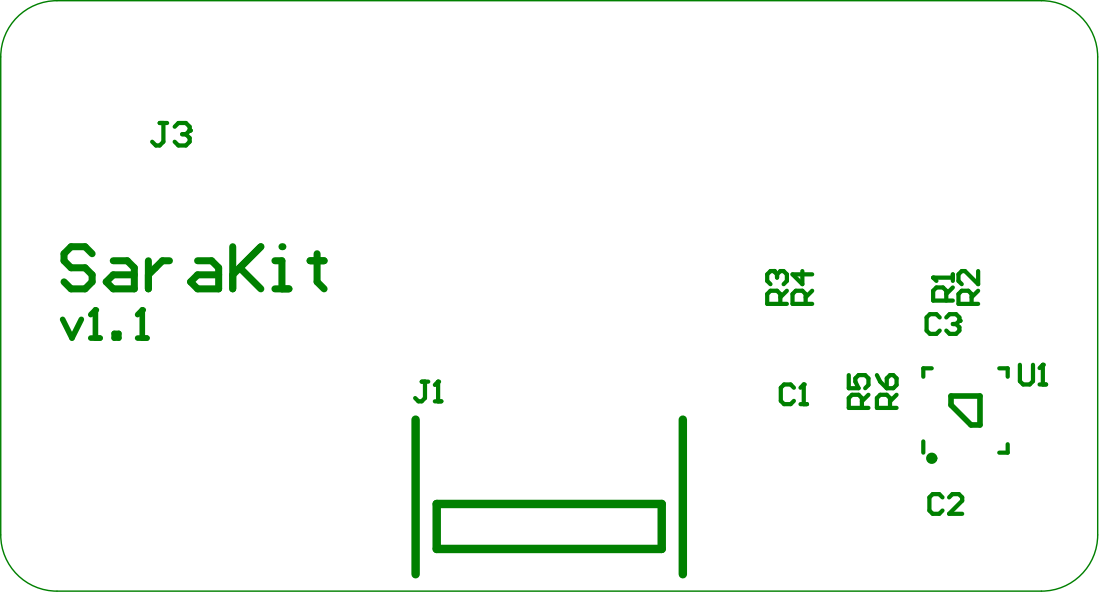
[picture p15: page 5]

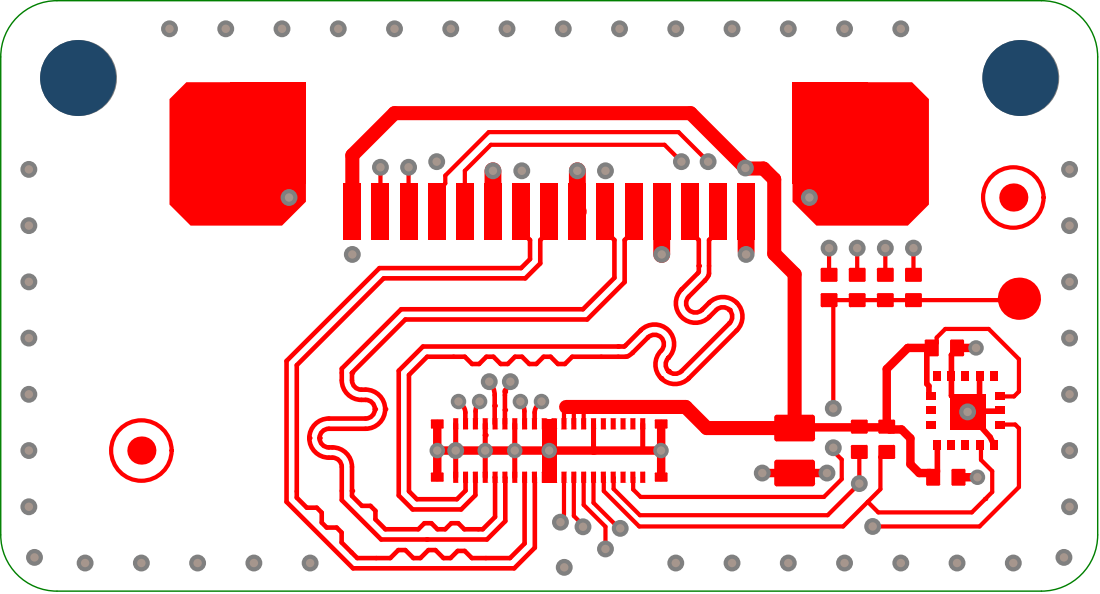
[picture p16: page 6]

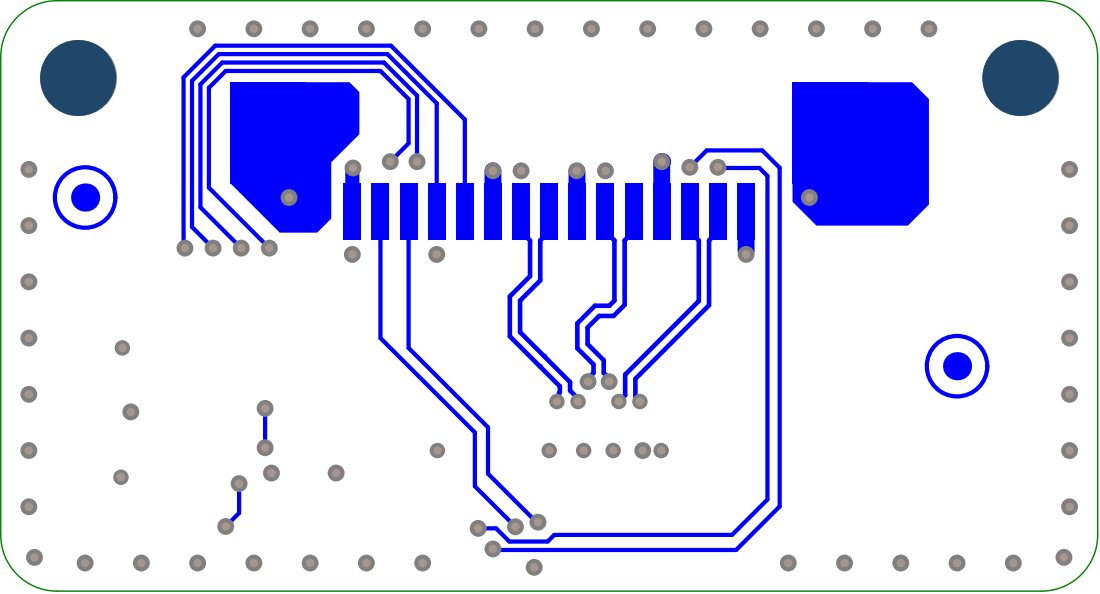
[picture p17: page 9]
