SaraEye/SaraKIT-Schematic-and-BOM/SaraKit_CameraHub_v11/out/[SCH] SaraKit_CameraHub [Standard] [v1.1] (2023-07-04 18-40).PDF

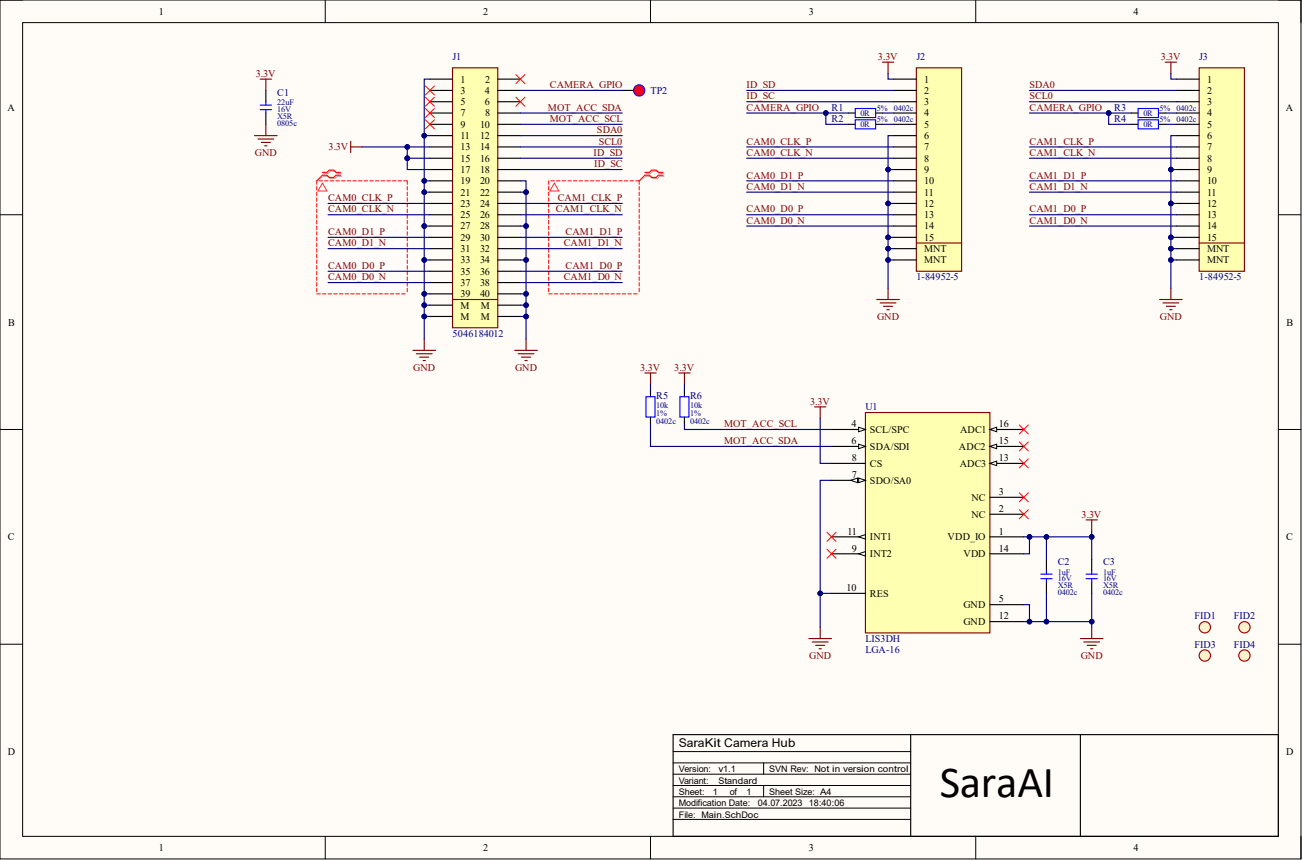
[picture p18: page 1]
