SaraEye/SaraKIT-Schematic-and-BOM/SaraKit_FlexHubConnector/out/[SCH] SaraKit_FlexHubConnector [[No Variations]] [v1.0] (2023-07-04 18-42).PDF

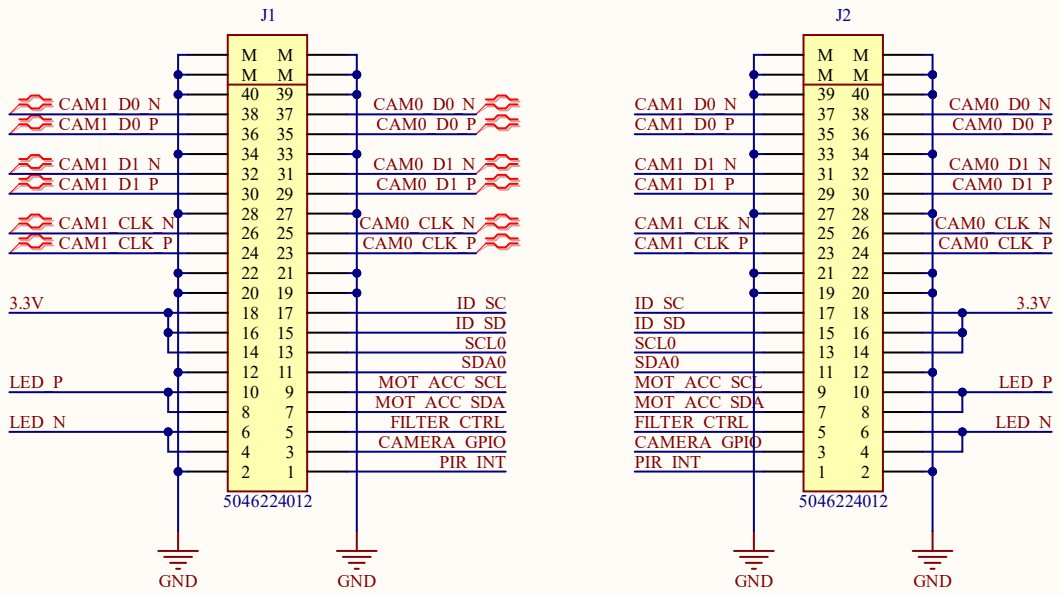
[picture p19: page 1]
