SaraEye/SaraKIT-Schematic-and-BOM/(list of files, drawings)

Other design files:
SaraKit_CameraHub_v11/pcb/pcb.PcbDoc
SaraKit_CameraHub_v11/SaraKit_CameraHub.PrjPcb
SaraKit_CameraHub_v11/sch/Main.SchDoc
SaraKit_FlexHubConnector/pcb/pcb.PcbDoc
SaraKit_FlexHubConnector/SaraKit_FlexHubConnector.PrjPcb
SaraKit_FlexHubConnector/sch/Schematic.SchDoc
SaraKit_MainBoard/SaraKit_MainBoard.PrjPcb
SaraKit_MainBoard/sch/Accelerometer.SchDoc
SaraKit_MainBoard/sch/Audio.SchDoc
SaraKit_MainBoard/sch/Audio_SpeakerDriver.SchDoc
SaraKit_MainBoard/sch/Main.SchDoc
SaraKit_MainBoard/sch/MotorController.SchDoc
SaraKit_MainBoard/sch/MotorsController.SchDoc
SaraKit_MainBoard/sch/PSU.SchDoc
